longmxuc/Intelligent-Monitoring-System/oled/README.md

# STM32 智能环境监测系统 Beta 3

面向 STM32F103C8T6（Cortex-M3）的多传感器环境监测项目，整合 **AHT20** 温湿度、 **BH1750** 亮度、 **BMP180** 气压/温度/海拔、 **MQ2** 烟雾/可燃气体传感器，并通过 0.96"~1.3" I²C OLED 实时展示。系统内建多层滤波、异常检测与双串口（Air780e 模块 + 蓝牙）的数据上传能力，可配合 GitHub/Open-Source 工作流使用。
> 👉 在线体验地址：https://znhj.iepose.cn

## 功能亮点

- **多传感器融合**：I²C 采集 AHT20/BH1750/BMP180 + ADC 采集 MQ2，实现环境温湿度、光照、气压/海拔与烟雾值的同步监测。
- **多层稳健滤波**：范围限幅 + 非对称变化率限制 + 中值滤波 + 趋势检测。
- **OLED 多页面 UI**：单键防抖切换三大页面（温湿度/亮度、气压温度/海拔、MQ2 Rs/Ro & PPM）。
- **双串口数据上传**：`USART3` 蓝牙 & `USART2` Air780e，依据 `BLE_STATE` 引脚自动切换，帧格式 `T=...H=...`。
- **异常阈值与告警**：温湿度/亮度/气压/PPM 超限持续 3s 触发 `Alert_SendWarning()`，自动选择可用串口推送告警。
- **远程控制**：`ONMQ2` / `OFFMQ2` 文本指令（两路串口均可）切换 MQ2 供电，便于节能或远程维护。
- **现代构建链路**：CMakePresets + Ninja + GCC ARM toolchain，可在 VS Code、CLion、CubeIDE CMake 工程等环境直接复现。

## 硬件组成

| 模块 | 接口/资源 | 说明 |
| --- | --- | --- |
| STM32F103C8T6 | Cortex-M3 @ 72 MHz，64 KB Flash | 主控，使用 STM32Cube HAL |
| OLED 128×64 | I²C（`hi2c1`） | 多页面数据显示 |
| AHT20 / DHT20 | I²C | 温湿度采集 |
| BH1750 | I²C | 亮度（Lux）测量，单次高分辨率模式 |
| BMP180 | I²C | 气压、温度、海拔（OSS_3） |
| MQ2 | ADC1 通道 + GPIO 控电 | 烟雾/可燃气体，支持快速校准 & 远程断电 |
| Air780e | USART2 + DMA | 蜂窝物联网模组上报数据 |
| 蓝牙模块（HC-05 等） | USART3 + DMA | 本地 BLE/串口透传 |
| SWITCH_KEY | PB12 输入 | OLED 页面切换 |
| BLE_STATE | PA8 输入 | 表示蓝牙连接状态，决定串口输出路由 |

## 接线图

> 所有 I²C 设备（OLED、AHT20、BH1750、BMP180）共用 `3.3 V` 与 `GND`，并并联在 `PB6/PB7` 上；MQ2 传感器使用 `5 V` 供电且模拟输出接入 `PA0`。

### I²C 总线（`hi2c1`，400 kHz）

| 设备 | VCC | GND | SCL | SDA | 备注 |
| --- | --- | --- | --- | --- | --- |
| OLED 128×64 | 3.3 V | GND | PB6 | PB7 | 地址 `0x3C`，I²C OLED |
| AHT20 | 3.3 V | GND | PB6 | PB7 | 地址 `0x38` |
| BH1750 | 3.3 V | GND | PB6 | PB7 | `ADDR` 接 VCC → 地址 `0x5C` |
| BMP180 | 3.3 V | GND | PB6 | PB7 | OSS_3，高精度模式 |

简化拓扑（俯视）：

```
PB6 ──────────┬─ OLED SCL
              ├─ AHT20 SCL
              ├─ BH1750 SCL
              └─ BMP180 SCL

PB7 ──────────┬─ OLED SDA
              ├─ AHT20 SDA
              ├─ BH1750 SDA
              └─ BMP180 SDA
```

### 模拟/控制接口

| 设备 | 引脚 | STM32F103 引脚 | 说明 |
| --- | --- | --- | --- |
| MQ2 模拟输出 | AOUT | `PA0` (`ADC1_IN0`) | 周期采样 + 多级滤波 |
| MQ2 供电 | VCC | 5 V | 建议同电源旁加 0.1 µF + 10 µF |
| MQ2 地 | GND | GND | 与 MCU 共地 |
| MQ2 电源控制 | EN/VCC_SW | `PB1` (`MQ2_POWER`) | `ONMQ2/OFFMQ2` 远程开关 |
| SWITCH_KEY | 一端 | `PB12` | 上拉输入 |
| SWITCH_KEY | 另一端 | GND | 按下接地实现页面切换 |
| BLE_STATE 输入 | 模块状态脚 | `PA8` | 高电平表示蓝牙连接，控制串口路由 |

### 串口与无线模组

| 通讯对象 | STM32 引脚 | 外设引脚 | 说明 |
| --- | --- | --- | --- |
| Air780e（蜂窝） | `PA2` (`USART2_TX`) → 模块 RX | `PA3` (`USART2_RX`) ← 模块 TX | 115200 bps，上报环境帧 |
| 蓝牙串口（HC-05 等） | `PB10` (`USART3_TX`) → 模块 RX | `PB11` (`USART3_RX`) ← 模块 TX | 9600 bps + DMA，BLE_STATE 决定是否发射 |

> 记得所有外设需与 MCU 共地；若外设逻辑为 5 V（如部分蓝牙模组），需使用电平转换或确认其兼容 3.3 V TTL。

## 目录结构

```
.
├── Core/                 # CubeMX 生成源码（main.c、外设驱动、传感器算法等）
│   ├── Inc/
│   └── Src/
├── Drivers/              # 请自行使用CubeMX生成
├── cmake/                # 工具链 & CubeMX 子项目配置
├── CMakeLists.txt
├── CMakePresets.json     # 预设构建配置（Debug/Release…）
├── oled.ioc              # STM32CubeMX 工程文件
├── STM32F103XX_FLASH.ld  # 链接脚本
└── startup_stm32f103xb.s
```

## 开发环境

- CMake ≥ 3.22
- Ninja ≥ 1.10
- `arm-none-eabi-gcc` 工具链（推荐 10.x 及以上）
- STM32CubeMX（如需重新生成外设初始化代码）
- ST-LINK CLI / STM32CubeProgrammer / `st-flash` 等烧录工具

> **Tip**：`cmake/gcc-arm-none-eabi.cmake` 已封装 MCU 目标、链接脚本、`-u _printf_float` 等细节，确保在 Windows/macOS/Linux 上统一体验。

## 构建步骤

```bash
# 1. 生成构建目录（以 Debug 为例）
cmake --preset Debug

# 2. 编译
cmake --build --preset Debug

# 3. 生成二进制（如需手动烧录）
arm-none-eabi-objcopy -O binary build/Debug/oled.elf build/Debug/oled.bin
```

构建输出位于 `build/<Preset>/`，含 `.elf`、`.map` 与编译数据库 `compile_commands.json`。

## 烧录与调试

1. **使用 ST-LINK CLI / CubeProgrammer**：直接加载 `build/Debug/oled.elf`，或转换后的 `oled.bin`。
2. **命令行示例（st-flash）**：
   ```bash
   st-flash write build/Debug/oled.bin 0x08000000
   ```
3. 烧录后通过 `USART3`（蓝牙）或 `USART2`（Air780e）监视串口帧，波特率与 CubeMX 设置一致（默认 115200）。

## 运行时逻辑

- **任务调度**：主循环以毫秒节拍轮询，非阻塞触发/读取各传感器：BH1750 一次性高分辨率、MQ2 周期性 ADC、BMP180 OSS_3、AHT20 500 ms 周期，并在同周期中刷新 OLED。
- **OLED 页面**：`SWITCH_KEY` 触发消抖，循环显示：
  1. 温度/湿度 + Lux；
  2. 气压（hPa）/BMP180 温度/海拔；
  3. MQ2 Rs/Ro + PPM。
- **滤波与校准**：系统上电后先执行 MQ2 快速校准（洁净空气中约 1s 完成）；传感器读数统一经过多层滤波，缓解 I²C 抖动、电源噪声与 ADC 跳变。
- **异常检测**：`Alert_CheckAndSend()` 按阈值（可在 `Core/Src/main.c` 中调整）跟踪各量的持续异常，超过 3 s 即通过可用串口发送一次告警字符。
- **串口输出**：周期性格式化 `T=%.2fH=%.2fL=%.1fR=%.2fY=%.1fW=%.2fP=%.2f\r\n`，`USART3` 仅在 `BLE_STATE=High`（蓝牙连接）时发送；否则由 `USART2`（Air780e）负责。
- **远程指令**：任何串口收到文本 `ONMQ2` / `OFFMQ2` 即通过 `MQ2_POWER` 引脚开/断传感器电源，支持 DMA 接收或字节流解析。

## 数据协议与扩展

示例上报：

```
T=25.31H=42.88L=123.4R=1.27Y=35.6W=24.5P=1012.8
```

| 字段 | 说明 |
| --- | --- |
| `T` | AHT20 过滤后的温度（℃） |
| `H` | AHT20 相对湿度（%） |
| `L` | BH1750 亮度（Lux） |
| `R` | MQ2 Rs/Ro 比值 |
| `Y` | MQ2 PPM（需已校准） |
| `W` | BMP180 温度（℃） |
| `P` | BMP180 气压（hPa） |

> 如在构建或部署过程中遇到问题，欢迎提交 Issue 或 PR。祝使用顺利！
