longmxuc/Intelligent-Monitoring-System/PythonProject/resource/img.jpg

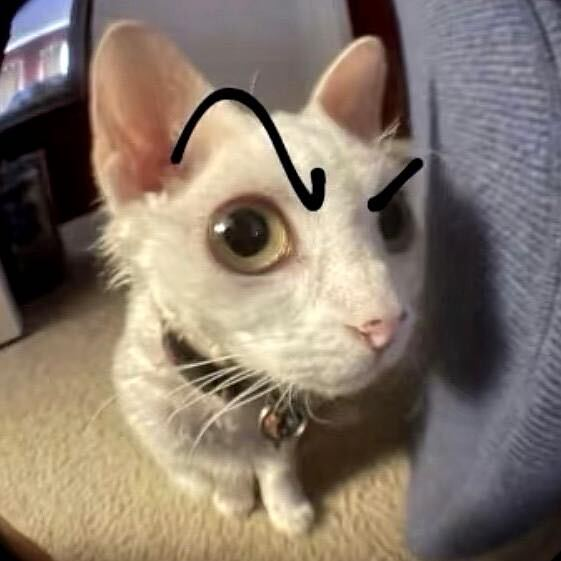
PythonProject/resource/img.jpg
