longmxuc/Intelligent-Monitoring-System/(commit log)

2025-11-20 更改MQTT订阅地址，为多设备做准备
2025-11-22 释放1.0
2025-11-24 完成正式版多设备更新
2025-11-24 更新了README
2025-12-06 同步推送Release 1.0.2，修复了已知问题，同时添加了按年份月份分类通知的功能
2025-12-07 修复了分析页顶部一直存在未修复的横线
2025-12-09 重写了部分api
2025-12-12 重写了彩蛋页，去掉了单片机的部分字库数据
2025-12-19 更新了README，合并了单片机的状态栏组件进main
