longmxuc/Intelligent-Monitoring-System/(notices)

Notices in the files:
oled/Core/Src/main.c:
Copyright (c) 2025 STMicroelectronics.
All rights reserved.
This software is licensed under terms that can be found in the LICENSE file
README.md:
License: GPLv3
